yttttyy/meteo_pwa/SPEC.md

# Метеостанция ESP32-S3 — спецификация (v2.3)

> Хендофф-документ. Прошивка переписана с нуля модульно (2026-07),
> v2.1: OTA, режим «Радуга», настройки с веба, --:--.
> v2.2: вкладки Главная/Настройки, история в LittleFS (переживает ребут), диапазон «Неделя».
> v2.3: функция уличной погоды (open-meteo) ПОЛНОСТЬЮ УДАЛЕНА по решению пользователя
> (сочтена лишней; заодно −120КБ флеша). Не возвращать без явной просьбы.
> v2.4: вкладка «Статус», рантайм-детект отвала датчиков (черточки вместо значений),
> стартовый экран «АДРЕС ПАНЕЛИ» с IP, meteo.local и отсчётом 5с.
> v2.5: узлы-сателлиты Meteo-Node (отдельная прошивка meteo_node/), сенсорная кнопка
> GPIO8 переключает LCD между домом и комнатами, комнаты на вебе.
> v2.6: касание кнопки пропускает стартовые экраны, экран адреса в режиме настройки
> показывает имя точки, «Забыть сеть», портал сразу при неудачном подключении.
> Тут зафиксированы ВСЕ требования, распиновка, логика и грабли.

---

## 0. Что это

Домашняя метеостанция на **ESP32-S3 Dev Module** в стиле AlexGyver MeteoClock:
большие цифры часов на LCD2004, датчики воздуха, веб-сервер + PWA для управления.

Функции:
- Большие цифры часов на LCD2004 (порт шрифта AlexGyver), время от NTP, дата + день недели
- Строки датчиков внизу (температура, влажность, CO₂, AQI, TVOC)
- RGB-подсветка LCD: авто-режим (градиент по CO₂ зелёный→жёлтый→красный), ручной цвет
  и **«Радуга»** (HSV-переливание, скорость слайдером). Тревога CO₂ (порог настраивается
  с веба, дефолт 1500) пульсирует красным поверх авто и радуги, но НЕ поверх ручного цвета
- **Авто-яркость** подсветки по фоторезистору (GPIO7) или ручной слайдер
- **OTA-прошивка**: секция «Система» на странице, POST .bin на /update (встроенный Update.h);
  .bin получать через «Скетч → Экспорт скомпилированного бинарного файла»
- **Настройки с веба** (Preferences): поправки T/H (аддитивные, уходят и в ENS160),
  порог тревоги CO₂
- Заглушка больших «-- : --» с мигающим двоеточием, пока времени нет ниоткуда
- **WiFi-провижининг**: креды в Preferences; нет сети / не подключилась за 20с →
  открытая AP «Meteo-Setup» + captive portal со списком сетей и полем пароля.
  Офлайн дольше 3 мин в рабочем режиме → AP поднимается параллельно STA
- Веб-страница (PWA): светлая/тёмная тема (по умолчанию системная, тумблер, localStorage),
  главный экран из плиток (балл климата со смайликом, параметры, окрашенные по порогам),
  детальный экран параметра с графиком **Час / 3 часа / День / Неделя**, экран подсветки,
  экран настроек — подробности в §6
- mDNS (meteo.local)
- Настройки в Preferences (переживают ребут)
- DS3231 RTC **опционален**: есть — время мгновенно после ребута и NTP пишет в него обратно;
  нет — время от NTP, а без интернета страница отдаёт время браузера через /settime
- ❌ Симуляции LCD-экрана на странице больше НЕТ (убрана сознательно)

---

## 1. Железо и среда

- **ESP32-S3**, Arduino framework (собрано на esp32 core 3.3.8)
- IDE: плата "ESP32S3 Dev Module", **USB CDC On Boot: Enabled**
- PWM: новый API `ledcAttach(pin,freq,bits)` / `ledcWrite(pin,duty)`
- LCD: HD44780/KS0066 с **кириллическим знакогенератором** (0xA5='И'), только 8 слотов CGRAM
- ⚠️ **КРИТИЧНО: GPIO43/44 = U0TXD/U0RXD (загрузочный UART)** — НЕЛЬЗЯ вешать UART-периферию,
  мешает прошивке. Симптомы конфликта: "Download timeout!", "CCCCCC". MH-Z19C поэтому на 15/16.

### Распиновка (ФИНАЛЬНАЯ)
```
I2C (LCD 0x27, ENS160 0x53, AHT21 0x38, DS3231 0x68): SDA=17, SCL=18
RGB подсветка (базы BC547 через 1кОм):  R=5, G=4, B=6
MH-Z19C: MHZ_RX=16 (<-TX датчика), MHZ_TX=15 (->RX датчика)   [НЕ 44/43!]
Фоторезистор: GPIO7 (ADC1_CH6; ADC2 при WiFi не работает!)
  Делитель: LDR от 3.3V к пину, ~10кОм от пина на GND (светло = ADC выше)
Сенсорная кнопка TTP223: VCC->3.3V, GND, OUT->GPIO8 (активный HIGH, пин с PULLDOWN)
Питание: ESP от USB-C; LCD/датчики/MH-Z19C от отдельного 5V ЛБП; GND общие
Анод подсветки LCD(pin15) -> 22Ом -> 5V; катоды R/G/B через 100Ом на коллекторы BC547
DS3231 (опционально): VCC->3.3V, GND, SDA->17, SCL->18
AHT21: питать через 3.3V (не VIN) — обойти греющийся LDO, точнее температура
```

### Аппаратные заметки (из прошлого опыта)
- TP4056 — зарядник, не БП (выход = напряжение банки 3.7-4.2В). Для 5V от USB-банки: IP5306 или буст 3.7→5В.
- Мигание экрана от MH-Z19 (импульсы ИК-лампы просаживают 5В) — кондёр 1000мкФ у датчика и у LCD + звёздное питание.
- DS3231 модули ZS-042 пытаются заряжать батарейку — ставить LIR2032 ЛИБО выпаять зарядный резистор (маркировка `201`) под обычную CR2032.
- I2C: у DS3231-модуля свои 4.7к подтяжки; если шина заглючит — снять подтяжки с одного модуля.

---

## 2. Библиотеки

LiquidCrystal_I2C (Martin Kubovčík), Adafruit AHTX0, DFRobot_ENS160,
MHZ19 (Jonathan Dempsey/WifWaf), WiFi, WebServer, **DNSServer** (captive portal),
ESPmDNS, Preferences, **Update** (OTA), **LittleFS** (история на штатном
SPIFFS-разделе 1.5МБ default-схемы), time.h, sys/time.h, RTClib (Adafruit), esp_sntp.h.
(ArduinoJson 7 установлена, но после удаления погоды в коде не используется.)

На esp32 core 3.3.8 `sntp_set_time_sync_notification_cb` компилится нормально.
Флеш занят на ~86%. Если упрёмся — переключить в IDE Partition Scheme:
"Minimal SPIFFS (1.9MB APP with OTA)" (min_spiffs). Важно: смена схемы разделов —
ТОЛЬКО прошивкой по USB (OTA таблицу разделов не меняет), и история в LittleFS
при этом сотрётся (раздел уменьшится до 190КБ — файлу в 6КБ хватит).

---

## 3. Структура прошивки (модульно, один translation unit)

```
meteo_pwa.ino   setup()/loop(), таймеры millis: 50мс подсветка, 200мс LDR,
                500мс часы, 15с датчики, 60с история, 30с WiFi-ретраи
config.h        все #define (см. §4)
globals.h       объекты (lcd, aht, ens, mhz, server, dnsServer, prefs, rtc) + состояние
bigdigits.h     CGRAM-битмапы + digSeg[2][10][6] + loadFont() + таблицы шрифтов
display.h       putCell/printRow/drawDig/drawDots/drawClock (частичная перерисовка)/
                drawDate/dayNames/drawSensors/redrawMain
backlight.h     setRGB/co2Target/hsv2rgb/backlightTick (авто|ручной|радуга + пульс тревоги) + ldrTick
nodes.h         узлы-сателлиты: Node nodes[4], findOrAddNode/nodeOnline (пуш < 90с),
                utf8ToLcd (UTF-8 кириллица -> коды KS0066 RUS, полная таблица 33 буквы)
history.h       LittleFS: saveHistory/loadHistory/historyInit (/hist.bin, magic MH03)
sensors.h       readSensors (оффсеты → компенсация ENS160), три кольцевых буфера истории
timekeeping.h   clockTick/onNtpSync/applyEpoch/initTimeFromRTC
wifi_portal.h   startAP/stopAP/netUp/connectSTA/wifiPoll/wifiTick + /wifi/* хендлеры
routes.h        все HTTP-хендлеры + setupRoutes()   [⚠️ НЕ называть webserver.h — см. §8]
web_assets.h    PROGMEM: INDEX_HTML_GZ (gzip из web/index.html), MANIFEST_JSON, ICON_SVG
```

---

## 4. Настройки (config.h)

```cpp
TZ_INFO   "EET-2EEST,M3.5.0/3,M10.5.0/4"
MDNS_NAME "meteo"
AP_SSID "Meteo-Setup", WIFI_CONNECT_MS 20000, WIFI_RETRY_MS 30000, WIFI_AP_FALLBACK_MS 180000
PIN_SDA 17, PIN_SCL 18, PIN_R 5, PIN_G 4, PIN_B 6
MHZ_RX 16, MHZ_TX 15          // НЕ 44/43!
PIN_LDR 7                     // только ADC1 (GPIO1-10)
LCD_ADDR 0x27
CO2_GRAD_MIN 500, CO2_GRAD_MAX 1400, CO2_ALARM 1500
LDR_PERIOD 200, LDR_SMOOTH 0.05f, BRIGHT_MIN 10, BRIGHT_MAX 255
SENS_PERIOD 15000, HIST_PERIOD 60000, HIST_LEN 180, HIST5_LEN 288
TEMP_OFFSET -3.9f             // калибровка AHT21 по эталону
HUM_OFFSET  13.0f             // процентные пункты, аддитивно (40% -> 53%)
CH_DOT 2, DEGREE_CHAR 5, FONT_RECT 0, FONT_ROUND 1
```

WiFi-креды НЕ в коде: Preferences ключи `ssid`/`pass`, настройка через AP.

---

## 5. Ключевая логика

### Большие цифры (порт AlexGyver) — как в v1
8 общих CGRAM-символов: UB(1), LB(4), UMB(6), LMB(7), DOT(2)=точка 2×2, DEG(5)=кольцо 4×4.
Под шрифт: FB(0) для RECT; CT(0)+CB(3) для ROUND. digSeg[2][10][6] — финальные таблицы
(единица — палка без флажка, 6 и 9 — цельная нижняя перекладина) — см. bigdigits.h.
Частичная перерисовка часов через pH10/pH1/pM10/pM1, ведущий ноль всегда.
dayNames кириллицей кодами знакогенератора: П=0xA8, Ч=0xAB, Б=0xA0.

### Датчики
- AHT21 → поправки TEMP_OFFSET/HUM_OFFSET → curTemp/curHum;
  **исправленные** значения кормятся в `ens.setTempAndHum()` (ENS160 компенсирует TVOC/AQI)
- MH-Z19C: `autoCalibration(false)`, ручная калибровка нуля через /calibrate
- **Рантайм-детект отвала**: счётчики подряд неудачных чтений (SENS_FAIL_N=3 ≈ 45с);
  AHT21 — getEvent()==false; ENS160 — AQI вне 1..5 (мёртвый I2C отдаёт 0);
  MH-Z19 — errorCode != RESULT_OK. `ahtLive()/ensLive()/mhzLive()` в globals.h.
  Мёртвый датчик → черточки на LCD («--.-° --% --- ppm», «AQI:- TVOC:--- ppb») и
  в веб-карточках («--»), история пишет последние значения (флэт). Вернувшийся
  I2C-датчик оживает сам; подключённый после старта — только после ребута.
- Стартовая последовательность LCD: **бегущий лог загрузки** → 2.5с →
  экран адреса (отсчёт 5с справа внизу, веб уже работает — handleClient крутится
  в цикле ожидания `waitOrTouch`) → главный экран. **Касание кнопки GPIO8 пропускает
  весь старт** (при выходе выставляются touchWas/touchLastMs, иначе прижатый палец
  тут же перелистнёт экран на комнату).
- Подсветка в авто-режиме красится **общим баллом климата** (climate.h, порт расчёта
  с веб-страницы): оттенок HSV от зелёного к красному той же функцией, что красит
  плитку «Климат в комнате», поэтому станция и веб показывают одно состояние одним
  цветом. Тревога CO₂ по-прежнему перебивает всё пульсирующим красным.
- Балл климата считает **только станция** (`climateScoreOf()`), отдаёт в `/data` полем
  `clim` (null — нет живых датчиков); страница его показывает и из него же берёт цвет.
  В JS агрегации нет — формула в одном месте, LCD и веб разойтись не могут.
- `/hist` отдаёт серию `k` — балл климата по каждой точке. **Не хранится**: считается
  на лету из сохранённых t/h/c/a/v/e тем же `climateScoreOf()`, поэтому формат
  `/hist.bin` не менялся и график есть сразу для всей старой истории. Состав
  участвующих параметров берётся по живости датчиков сейчас.
- Тренд CO₂ (`curTrend`, -1/0/+1): свежая минутная точка против точки `TREND_BACK`
  минут назад, мёртвая зона `TREND_DEAD` ppm. Считается в `updateTrend()` раз в минуту
  из `pushHistory()`. Нет MH-Z19C — по eCO₂. На вебе стрелка ↑/↓ на плитке CO₂,
  в `/data` поле `trend`.
- Стрелка на LCD — своя графика в CGRAM. В шрифте «палки» слот 3 свободен (вертикали
  берут слот 0=FB), туда и грузится стрелка; обе формы живут в одном слоте и
  переписываются в `loadArrow()` при смене тренда, т.к. на экране их всегда не больше
  одной. В скруглённом шрифте слот 3 занят под CB — там остаётся ASCII `^`/`v`.
  `loadFont()` сбрасывает `arrowLoaded`, иначе после переключения шрифта в слоте
  осталась бы CB.
- Пороги зон живут в станции (Preferences, ключи `thr_<имя>`, дефолты в climate.h),
  отдаются в `/data` полем `thr`, правятся через `/cfg?thr_co2=800,1000,1500&save=1`.
  Набор обязан строго возрастать — иначе `segIdx` делит на ноль; `parseThr` такое
  отвергает, страница дополнительно подсвечивает поле. Источник правды один,
  localStorage для порогов больше не используется.
- Лог загрузки: `bootBegin(имя)` печатает «ENS160...... » (имя добито точками до 12),
  `bootEnd(статус)` дописывает результат, когда он известен — WiFi думает до 20с.
  Строки: AHT21, ENS160, MH-Z19C, WIFI, DS3231, FS/HISTORY, MDNS; пятая и дальше
  сдвигают лог вверх (буфер `bootLines[4][21]`, счётчик `bootN`).
- Экран адреса строится через `utf8ToLcd()`: в STA — «АДРЕС ПАНЕЛИ / \<IP\> /
  meteo.local» (имя показывается только при `mdnsStarted`, иначе строка пустая —
  не обещаем адрес, который не отрезолвится), в AP — «ПОДКЛЮЧИСЬ К СЕТИ /
  Meteo-Setup / 192.168.4.1».

### Узлы-сателлиты (Meteo-Node, v2.5)
- Отдельная прошивка **meteo_node/** (ESP32-S3, AHT21+ENS160 на I2C 17/18, свои оффсеты
  NODE_TEMP_OFFSET/NODE_HUM_OFFSET). Портал настройки как у станции: AP «Meteo-Node»,
  captive portal, форма: сеть+пароль+имя комнаты+адрес станции (дефолт meteo.local).
  Страница узла: http://meteonode.local (показания, настройки, OTA, /info /scan /save).
- Узел шлёт GET `/api/push?id&name&t&h&aqi&tvoc&eco2` раз в 20с; id = efuse MAC >> 16;
  meteo.local резолвится MDNS.queryHost с кэшем, 3 неудачных пуша → перерезолв.
- Станция: nodes[4] в RAM, регистрация по первому пушу, пуш > 90с назад = офлайн.
- **Сенсорная кнопка GPIO8**: цикл LCD «дом → узел0 → … → дом» (опрос 30мс, дебаунс 250мс,
  PULLDOWN — без кнопки не дребезжит). Вид узла: строки 0-1 (часы/дата) не трогаются,
  строка 2 = temp/hum/**eCO₂** ppm, строка 3 = ИМЯ (кириллицей, utf8ToLcd) слева + AQI:n
  справа. Узел офлайн → черточки, имя остаётся. **Автовозврат на дом через 30с.**
- Веб: чипсы комнат над карточками (Дом + имена узлов, появляются когда узлы есть);
  у узла карточка CO₂ = «--» (нет MH-Z19). Вкладка Статус: секция «Узлы» с бейджами
  онлайн/офлайн и «молчит N с». Истории узлов нет (только текущие значения) — задел.
- История: минутный буфер 180 т. (час/3 часа) + 5-минутные средние 288 т. (сутки) +
  часовые средние 168 т. (неделя). Серии: T, H, CO₂, AQI, TVOC, **eCO₂**.
  **Переживает ребут**: history.h пишет все буферы
  и аккумуляторы в LittleFS `/hist.bin` раз в 5 минут и перед /reboot и OTA;
  на буте восстанавливает (если файл не старше 24ч и не битый — проверка magic+размер).
  Износ: ~105к записей/год по ~6КБ на wear-leveled 1.5МБ — безопасно.

### Подсветка и яркость
- Авто-цвет: градиент co2Target (t=(CO2-500)/900), сглаживание ×0.02 каждые 50мс;
  CO2≥1500 → пульс `k=0.7+0.3*sinf(millis()/120.0f)` (0.4..1.0, НЕ до нуля)
- Яркость: ручная (слайдер) или авто — ldrTick каждые 200мс, EMA 0.05,
  map(ADC 0..4095 → 10..255). curBright масштабирует все каналы в setRGB.

### WiFi
- Boot: креды есть → connectSTA (20с блокирующе, статус на LCD). Успех → netUp()
  (NTP+колбэк→RTC, mDNS). Неудача/нет кред → startAP (WIFI_AP_STA + DNSServer:53 → 192.168.4.1)
- Captive portal: onNotFound → 302 на софтап-IP (ловит generate_204 и т.п.)
- /wifi/save ставит флаг, подключение выполняется из loop (после отправки ответа);
  при успехе AP гаснет через 60с (apStopAtMs), **при неудаче AP поднимается сразу**
  (не ждём WIFI_AP_FALLBACK_MS — иначе опечатка в пароле = 3 минуты без портала)
- Рабочий режим: ретрай каждые 30с; офлайн >3 мин → AP параллельно STA
- `/wifi/forget` (кнопка «Забыть сеть» в Настройки → WiFi): стирает креды из Preferences,
  disconnect + startAP

**Сценарий переезда / смены сети (штатный, без USB):**
1. На новом месте станция 20с ищет старую сеть, не находит → сама поднимает открытую
   «Meteo-Setup»; LCD показывает имя точки и 192.168.4.1
2. Телефон подключается к «Meteo-Setup» → captive portal открывается сам → скан → новая
   сеть + пароль → станция подключается, AP гаснет через минуту, работает meteo.local
3. Планово: заранее нажать «Забыть сеть» — станция встретит порталом сразу
4. Узел-сателлит проходит то же самое со своей AP «Meteo-Node»; станцию он ищет по mDNS
   `meteo.local`, поэтому после переезда узлы находят её сами, без перенастройки адреса

### Время
- initTimeFromRTC: rtcOk=rtc.begin(); валидное время → settimeofday сразу
- NTP: sntp_set_time_sync_notification_cb(onNtpSync) → rtc.adjust
- Нет времени: /data отдаёт timeok:false → страница шлёт /settime?e=<epoch UTC>
- tzset(TZ_INFO) ВСЕГДА, даже офлайн

### HTTP API
```
GET /            страница         GET /manifest.json, /icon.svg
GET /data        {temp,hum,co2,aqi,tvoc,eco2,auto,r,g,b,bright,bauto,ldr,font,timeok,sta,ssid,ip,rssi}
GET /hist?range=h|3h|day|week   {step,now,t[],h[],c[],a[],v[],e[]}
GET /export?range=h|3h|day|week CSV-выгрузка истории (ts,iso,temp,hum,co2,eco2,aqi,tvoc),
                                отдаётся чанками, Content-Disposition: attachment
GET /rgb?mode=auto|manual|rainbow&r&g&b&spd[&save=1]
GET /bright?mode=auto|manual&v[&save=1]
GET /font?f=0|1[&save=1]
GET /cfg?toff&hoff&co2al[&save=1]        поправки датчиков + порог тревоги
GET /api/push?id&name&t&h&aqi&tvoc&eco2  пуш от узла-сателлита
GET /calibrate   GET /settime?e=<epoch>
POST /update     OTA (multipart .bin)    GET /reboot
GET /wifi/scan   [{ssid,rssi,open}]     GET /wifi/save?ssid&pass    GET /wifi/status
```
/data дополнительно отдаёт: cmode,rspd,toff,hoff,co2al,fw,
aht/ens/mhz (0=ОК,1=отвалился,2=не найден), rtc,up,heap,
nodes:[{id,name,t,h,aqi,tvoc,eco2,age,on}].
Preferences пишутся только при save=1 (бережём флеш).

---

## 6. Веб-страница (web_assets.h)

Один самодостаточный файл, всё inline PROGMEM, без CDN и внешних шрифтов — работает
офлайн и через AP. Отдаётся gzip'ом (build_web.py -> INDEX_HTML_GZ, handleRoot ставит
Content-Encoding). Дизайн — порт экспорта из `design/` (design-desktop.html + design-mobile_1.html).

**Токены** на `html[data-theme]`, обе темы: `--bg --sf --tx --mu --ln --on` и зоны
`--z0..--z3` (зелёный -> жёлтый -> оранжевый -> красный). Скрипт в head ставит тему до
первой отрисовки (нет мигания), дефолт из prefers-color-scheme, выбор в localStorage `theme`,
meta theme-color обновляется. Смена темы — переход цветов 0.45s.
Плитки угловатые: radius 4px, рамка 1px `--ln`, полоса `.stripe` 3px сверху цветом зоны.
Цифры — `ui-monospace` + tabular-nums.

**Сетка.** Десктоп: 12 колонок, max-width 1360. Климат c5 + CO₂ c7; температура c3,
влажность c3, TVOC c2, AQI c2, eCO₂ c2; подсветка c6 + три квадратные плитки-кнопки c2
(Графики, Тема, Настройки). До 1000px — мобильная раскладка по design-mobile: 2 колонки,
`grid-auto-rows:126px`, климат span 2x2, CO₂ span 2x2 (иначе содержимое режется overflow),
подсветка span 3 строки.

**Климат.** Балл берётся готовым из `/data.clim` — формула живёт только в climate.h,
веб её не дублирует. Цвет `mix(Z, (90-clim)/70)`, смайлик из символов на 5 состояний
(`(^-^) (^_^) (-_-) (>_<) (x_x)`), вердикт словом, подсказка от худшего параметра,
метка на четырёхзонной шкале на позиции `clim%`. По референсным скриншотам смайлик
крупный (76px), балл — мелкой строкой.

**Плитки параметров.** `ev()` даёт индекс «плохости» 0..4 из порогов (двусторонние
шестиэлементные у температуры и влажности — зеркалированием), цвет `mix(Z, i/3)`,
подпись зоны словом, ширина `.meter` = `8+t*92`%. Отвалившийся датчик (aht/ens/mhz != 0) —
пунктирная рамка, «--», «Датчик недоступен». У CO₂ стрелка тренда рядом со значением.

**Графики — inline SVG** (viewBox 0 0 600 160, `preserveAspectRatio=none`), не canvas:
`y(v) = 150 - clamp((v-lo)/(hi-lo))*140`, заливка `polygon.area` + линия. Домен фиксирован
на параметр, но расширяется, если данные вышли за него. Две пунктирные линии порогов
с подписями. У CO₂ поверх — eCO₂ пунктиром. Спарклайны у температуры и влажности
(viewBox 0 0 100 30, нормировка по своим min/max).
Подсказки на всех графиках и спарклайнах: вертикальная линия, точка, плашка со значением
и временем; плашка клампится к краям.

**Листы «Графики» и «Настройки»** вместо отдельных экранов. Открытие: иконка крутится
250 мс (шестерёнка 180°, линия графика 360°), затем лист появляется на месте плитки и
за 500 мс растягивается на всю сетку (FLIP по offsetTop/Left/Width/Height), потом
проявляется содержимое. Закрытие в обратном порядке. Привязаны к hash (`#charts`,
`#settings`) — кнопка «назад» и Esc закрывают; при прямом заходе по ссылке открываются
без анимации. prefers-reduced-motion отключает всё.
- Графики: переключатель Час/3 часа/День/Неделя и 7 карточек — климат на всю ширину,
  дальше CO₂, eCO₂, температура, влажность, TVOC, AQI; у каждой текущее значение,
  мин/ср/макс и подписи оси.
- Настройки: датчики (бейджи ОК/отвалился/не найден), связь и система, WiFi
  (скан/подключение/забыть), пороги зон, поправки и тревога CO₂, калибровка нуля,
  шрифт часов с превью, экспорт CSV, OTA и перезагрузка.

**Пороги** живут в станции: читаются из `/data.thr` на первом поллинге, пишутся
`/cfg?thr_<имя>=a,b,c&save=1` (все шесть групп разом). Редактор проверяет строгое
возрастание и подсвечивает кривую строку. localStorage для порогов не используется.

**Подсветка** — одна плитка: образец цвета, режим (Авто (климат) / Свой цвет / Радуга),
палитра из 9 цветов + системная пипетка, скорость радуги, ползунок яркости с авто-режимом
по фоторезистору. Дебаунс 150 мс у цвета и скорости, 120 мс у яркости; `save=1` на отпускании.
Тревога CO₂ (`cmode != 1 && co2 >= co2al`) перебивает образец красным.

**Шапка:** имя, точка состояния, уровень WiFi палочками (>=-55: 4, >=-67: 3, >=-75: 2,
>=-85: 1), точное значение в title, часы браузера. В режиме AP — баннер со ссылкой в настройки.

`/data` раз в 15 с, `/hist` кэшируется по диапазону и перезапрашивается не чаще раза в 30 с.
Узлы-сателлиты в интерфейсе не показываются (поле nodes игнорируется).
Маркеры `<!--DEV-->...<!--/DEV-->` вокруг dev-mock.js вырезает build_web.py.
⚠️ Атрибут `hidden` слабее классов вроде `.pal{display:flex}` — в CSS есть
`[hidden]{display:none!important}`, без него скрытое остаётся видимым.

---

## 7. Вспомогательный скетч charmap_dump/charmap_dump.ino

Выводит все коды 0x00-0xFF страницами (4 стр × 4 строки, метка "Hx" + 16 символов), delay(5000).
Для снятия карты знакогенератора со своего дисплея (кириллический ROM).

---

## 8. Грабли (НЕ повторять)

- **0xFF на кириллическом ROM — не сплошной блок.** Нельзя освобождать CGRAM заменой углов на 255.
- **Код 165/0xA5 = 'И'.** Двоеточие — свой символ DOT, не ROM.
- **Градус** — кольцо 4×4 с пустотой 2×2, не больше.
- **MH-Z19 на 43/44 не работает** — загрузочный UART. Только 15/16.
- **Мигание алярма** — синус /120, диапазон 0.4..1.0 (не до нуля).
- **Часы моргали целиком** — только частичная перерисовка (pH10/pH1/pM10/pM1).
- **⚠️ НЕ называть свой файл `webserver.h`** — Windows-ФС регистронезависимая,
  он перекрывает библиотечный `<WebServer.h>` и всё разваливается. Поэтому `routes.h`.
- **LDR только на ADC1 (GPIO1-10)** — ADC2 занят WiFi.
- На будущее, если появятся HTTP(S)-фичи (Telegram, API и т.п.):
  запросы — только в задаче на core 0 (TLS-хендшейк ~1-3с морозит loop и часы);
  **HTTPClient + deserializeJson(stream) требует `http.useHTTP10(true)`** — иначе chunked
  ломает парсер (симптом: «жду данные» при рабочем интернете); стек TLS-задачи минимум 16К.
  Погода на этом уже обжигалась (удалена в v2.3).
- **Кириллица кодами знакогенератора**: подтверждены Б=A0,Ж=A3,И=A5,Л=A7,П=A8,Ч=AB;
  остальное по стандартной KS0066 RUS (Г=A1,З=A4,У=A9,Я=B1,Д=E0,Ь=B4) — при мусоре
  на живом экране снять карту charmap_dump'ом.
- Сборка: `arduino-cli compile --fqbn esp32:esp32:esp32s3:CDCOnBoot=cdc .`
  (cli лежит в Arduino IDE: resources/app/lib/backend/resources/arduino-cli.exe)

---

## 9. Возможные будущие правки (упоминались, не подтверждены)

- Проверить цифру 6 на реальном дисплее
- История, переживающая ребут / длинная история на LittleFS (неделя/месяц, CSV-экспорт)
- Telegram-уведомления (CO₂, отказ датчика, ребут)
- BMP280/BME280 → давление + локальный прогноз по Замбретти
- Пищалка на тревогу, кнопка переключения экранов
- MQTT / Home Assistant discovery
