yttttyy/meteo_pwa/design/design-desktop.html

Метеостанция

онлайн · · обновлено 15 с назад

21:35

Климат в комнате{{face}}

{{score}}/100

{{emo}}

{{hint}}

0 · плохо100 · отлично

CO₂ · MH-Z19C · 3 часа{{co2.st}}

{{co2.val}}ppm

мин {{co2.mn}} · макс {{co2.mx}}

10001500 {{co2.hv}}{{co2.ht}}

−3 ч−2 ч−1 чсейчас

{{it.name}}

{{it.val}}{{it.unit}}

{{it.hv}}{{it.ht}}

{{it.st}}

Подсветка

{{ledName}}

{{ledSub}}

любой

Скорость{{rspd}}

Авто (CO₂)Свой цветРадуга

Графики все датчики и климат Тема {{themeName}} Настройки WiFi, пороги, OTA

{{sh.title}} {{sh.cap}}

Настройки

прошивка v2.4 · изменения сохраняются сразу

Датчики3 из 4 в норме

AHT21t°, влажностьОК

ENS160AQI, TVOC, eCO₂eCO₂ молчит

MH-Z19CCO₂ОК

DS3231часыОК

ФоторезисторADC 2310 · 56%

Связь и система

WiFiHome_5G · 192.168.1.42

Времясинхр. · RTC

Аптайм3 д 4 ч 12 мин

Свободная RAM142 КБ

Прошивкаv2.4

WiFi

Home_5G−58 dBmонлайн

{{wifiBtn}}Забыть сеть

{{n.ssid}}{{n.sec}} · {{n.rssi}} dBm

Подключить

Без сети станция поднимет точку Meteo-Setup с этой же страницей.

Пороги зонСбросить

{{r.name}}{{r.note}}

{{f.label}}

Хранятся в браузере (localStorage). Плитки сразу перекрашиваются по новым границам.

Поправки датчиков Температура{{toffS}} Влажность{{hoffS}} Тревога CO₂{{co2al}}

Поправки прибавляются к сырым показаниям AHT21. Выше порога тревоги подсветка пульсирует красным.

Калибровка нуля CO₂

Калибровать как 400 ppmсейчас {{co2v}} ppm

Только на свежем воздухе после 20+ минут работы датчика.

Шрифт часов

21:35

ПалкиСкруглённый

Экспорт истории

{{e.label}}

Скачать CSV · {{expLabel}}

Колонки ts, iso, temp, hum, co2, eco2, aqi, tvoc.

Прошивка и перезагрузка

Прошить OTA Перезагрузить

Arduino IDE: Скетч → Экспорт скомпилированного бинарного файла, залить .bin сюда — без USB.

Графики

все датчики · точка раз в минуту

{{r.label}}

{{c.name}}{{c.st}}

{{c.val}}{{c.unit}}

{{c.stats}}

{{c.t1}}{{c.t2}} {{c.hv}}{{c.ht}}

Нет данных — датчик не отвечает

{{c.ax0}}{{c.ax1}}сейчас

Демо (только в макете) WiFi{{rssi}} dBm Поворот иконок{{spinMs}} мс CO₂{{co2v}} ppm Влажность{{humv}} %
