yttttyy/meteo_pwa/design/photo_2026-10-26_01-33-18.jpg

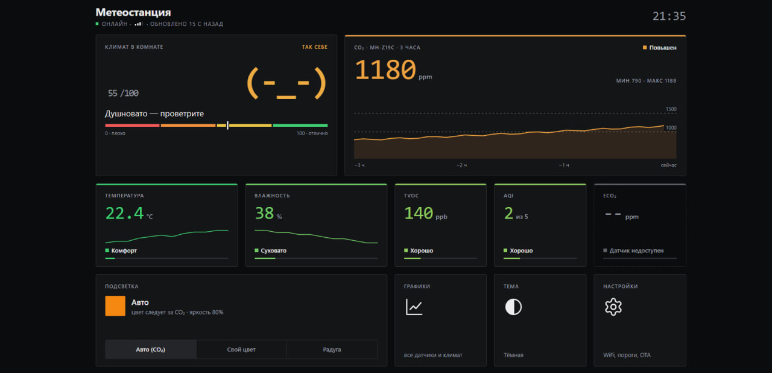
design/photo_2026-10-26_01-33-18.jpg
