yttttyy/meteo_pwa/design/photo_2026-10-26_01-35-02.jpg

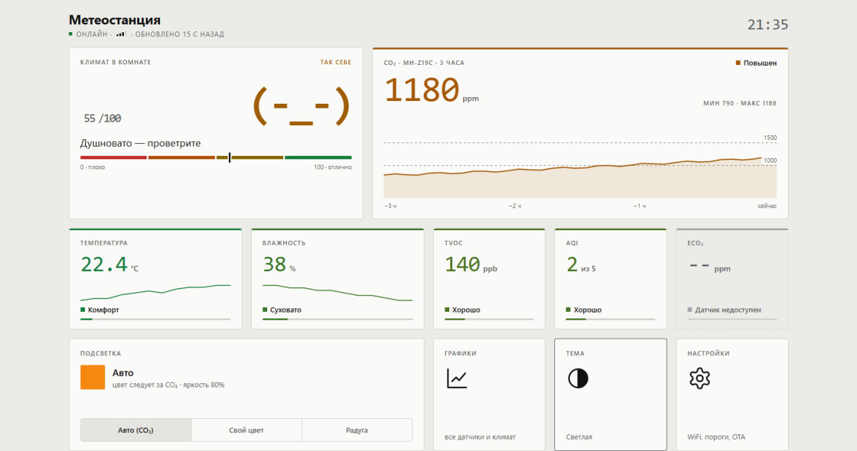
design/photo_2026-10-26_01-35-02.jpg
