yttttyy/meteo_pwa/web_assets.h

#pragma once
#include <Arduino.h>

// ================== ВЕБ-СТРАНИЦА (PWA) ==================
// !!! INDEX_HTML_GZ НЕ РЕДАКТИРОВАТЬ ЗДЕСЬ — это сжатый gzip'ом web/index.html.
// Правь web/index.html (VS Code + Live Server), потом: python build_web.py
// Всё inline, без CDN — страница обязана работать офлайн (в т.ч. через AP настройки).
// 57738 байт HTML -> 17958 байт gzip
const uint8_t INDEX_HTML_GZ[] PROGMEM = {
0x1f,0x8b,0x08,0x00,0x00,0x00,0x00,0x00,0x02,0xff,0xed,0x7d,0x6b,0x93,0xdc,0xc6,
0x91,0xe0,0xf7,0xf9,0x15,0xe0,0xc8,0x22,0x1a,0x1c,0x34,0xa6,0x1f,0xd3,0xc3,0x61,
0x37,0x31,0xb3,0x12,0x29,0x99,0x0a,0x8b,0x92,0x96,0xa4,0xe5,0x3d,0xcf,0xcd,0x2a,
0xd0,0x00,0xba,0x1b,0x1e,0x34,0xd0,0x02,0x30,0x2f,0x36,0xe7,0x42,0x8f,0xf5,0x2b,
0xe4,0x93,0x56,0xde,0xbd,0xdb,0x8d,0xbd,0xdd,0xf3,0xd9,0xfb,0xb8,0x8b,0xb8,0xb8,
0xb8,0x11,0x6d,0x5a,0x14,0x49,0x51,0x11,0xfe,0x05,0x3d,0x7f,0xc1,0xbf,0xe0,0x7e,
0xc2,0x65,0x66,0x55,0x01,0x05,0x34,0xd0,0x33,0x23,0xcb,0x71,0xb7,0x71,0xa7,0xc7,
0x34,0x50,0xa8,0x47,0x56,0x56,0x66,0x56,0x66,0x56,0x56,0xd5,0xf5,0x4b,0x4e,0x68,
0x27,0x47,0x13,0x57,0x19,0x25,0x63,0x7f,0x73,0xe9,0x3a,0xfe,0x28,0xbe,0x15,0x0c,
0xcd,0xe5,0x68,0x6f,0x19,0x13,0x5c,0xcb,0x81,0x9f,0xb1,0x9b,0x58,0x8a,0x3d,0xb2,
0xa2,0xd8,0x4d,0xcc,0xe5,0xbd,0x64,0x50,0xdf,0x58,0x16,0xc9,0x81,0x35,0x76,0xcd,
0xe5,0x7d,0xcf,0x3d,0x98,0x84,0x51,0xb2,0xac,0xd8,0x61,0x90,0xb8,0x01,0x64,0x3b,
0xf0,0x9c,0x64,0x64,0x3a,0xee,0xbe,0x67,0xbb,0x75,0x7a,0xd1,0xbd,0xc0,0x4b,0x3c,
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
